rudra-goel/personal_acoustic_spaces/Notes for Reviewing Papers.rtf

Do a summary, list strength and weakness (in bullets)

Look out for how it is useful in the real world? Can I as the author see a use case for their research

One use case is:
Image a movie theatre where you have two different languages, you can seat people on different sides of a theatre and then play different audios at the same theatre but beam formed at different zones.

Convert images to .EPS or .PDF format to prevent blurring

Notes for Writing the Paper

Abstract
Introduction
- Motivation
Background
- Design
- include equations for the design of the Labyrinthine here
Evaluation and results
- Micro benchmakrs
- Directionality
- Gain
