rudra-goel/personal_acoustic_spaces/GT Lib database contacts.png

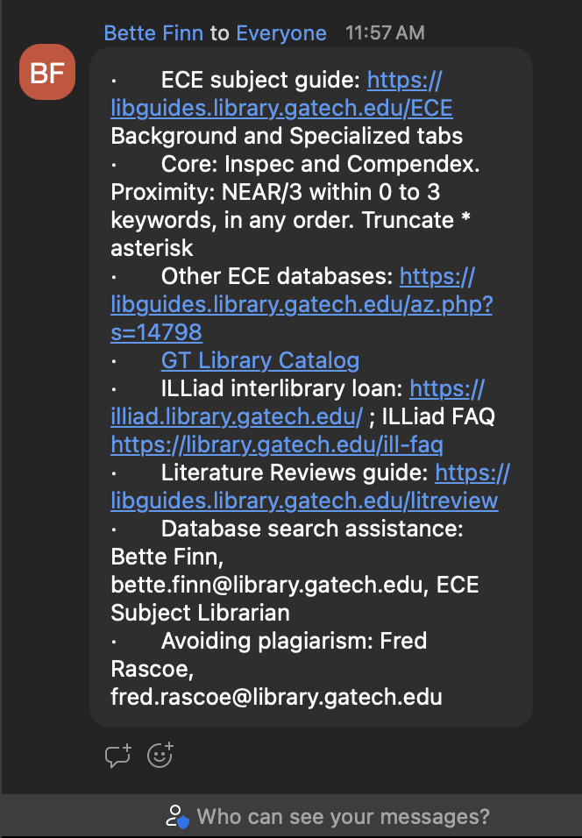
GT Lib database contacts.png
