rudra-goel/personal_acoustic_spaces/Labyrithine.png

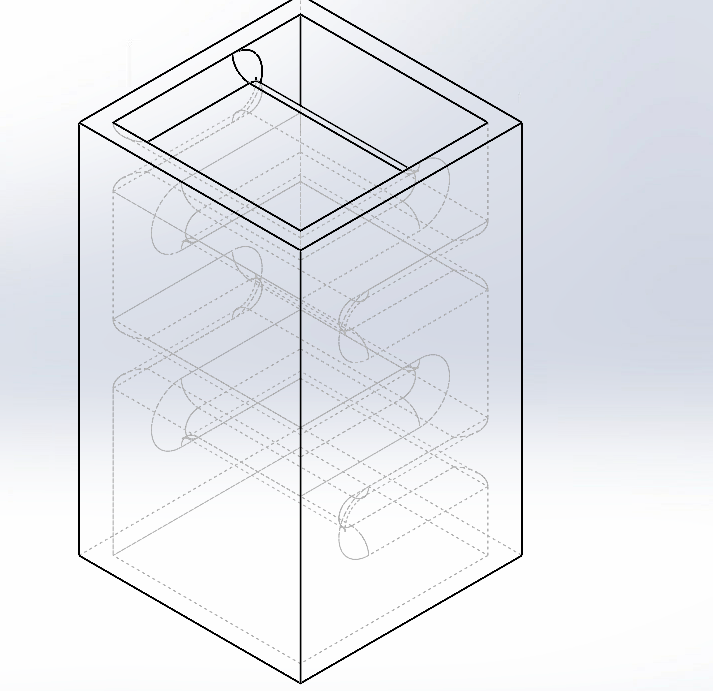
Labyrithine.png
