rudra-goel/personal_acoustic_spaces/Linear Phase Response_unwrapped.png

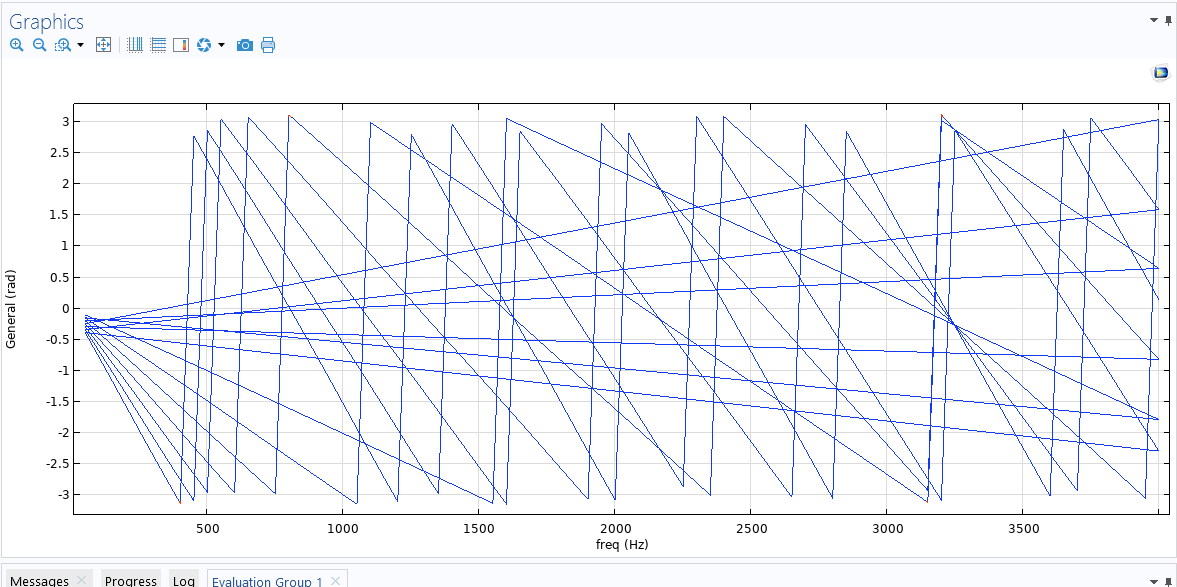
Linear Phase Response_unwrapped.png
