rudra-goel/personal_acoustic_spaces/linear Phase Responser.png

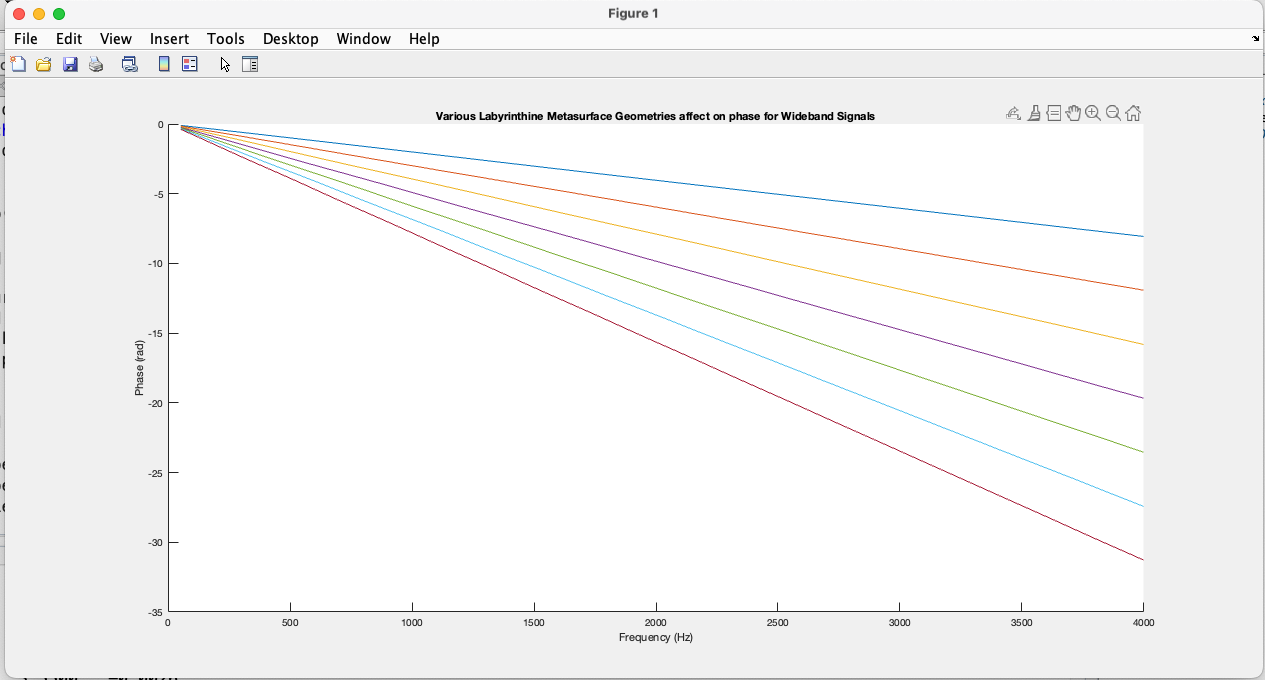
linear Phase Responser.png
