rudra-goel/personal_acoustic_spaces/SPiDR Stencils/stencil_3cm.stl

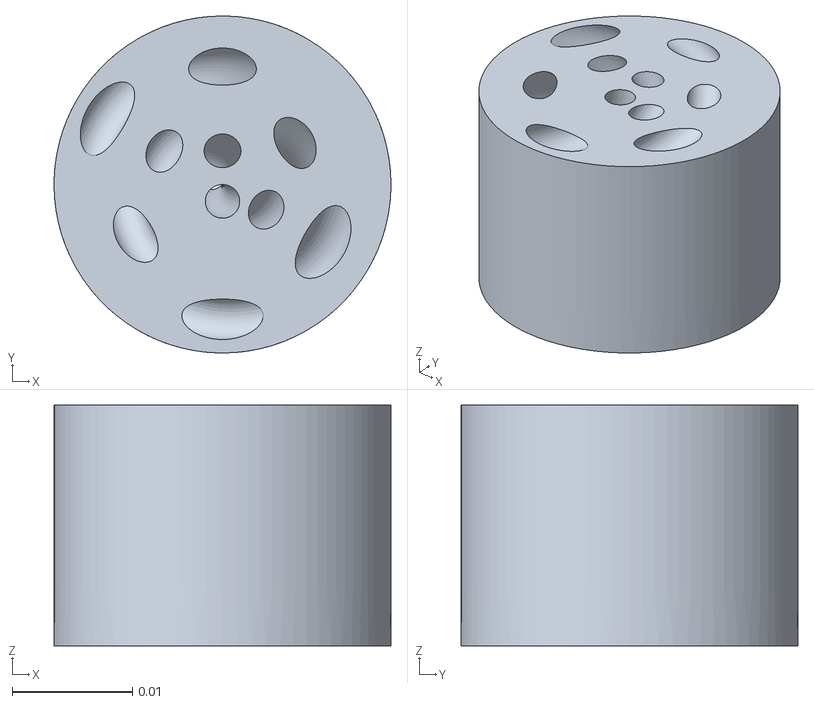
[picture p30: CAD file, 2025-05-13]
SPiDR Stencils/stencil_3cm.stl
0.028 x 0.028 x 0.02
