rudra-goel/personal_acoustic_spaces/SPiDR Stencils/stencil_5cm.stl

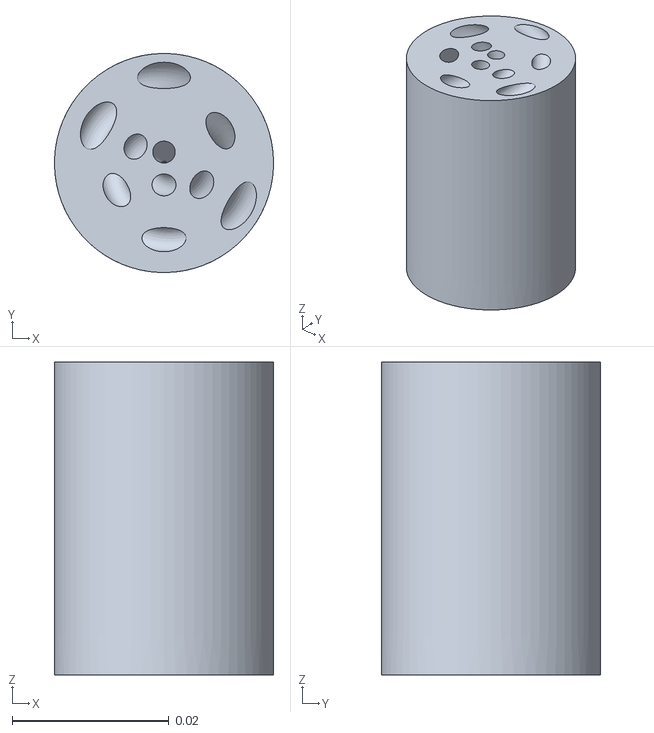
[picture p31: CAD file, 2025-05-13]
SPiDR Stencils/stencil_5cm.stl
0.028 x 0.028 x 0.04
